flukso/kube/enclosure/kube.stl

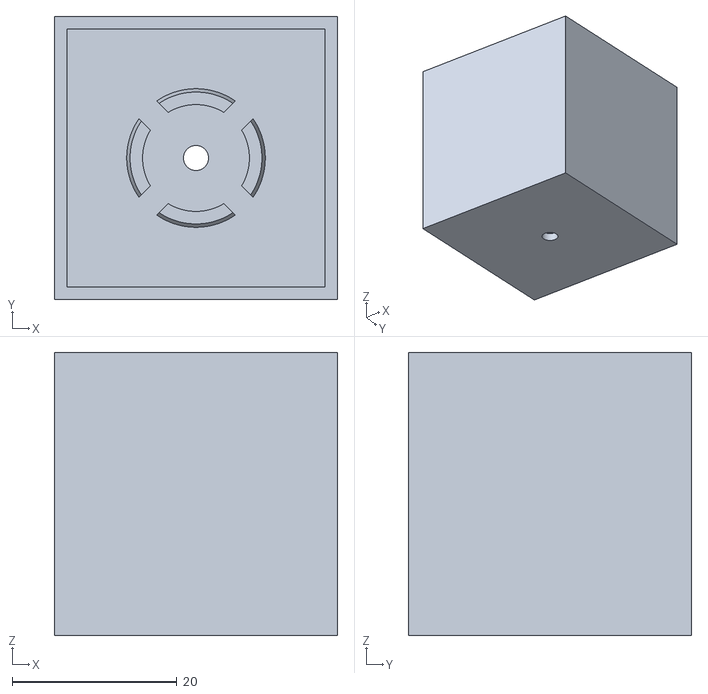
[picture p1: CAD file, 2015-09-16]
enclosure/kube.stl
34.4 x 34.4 x 34.4
