flukso/kube/FLK01B/FLK01B.brd

## EAGLE design FLK01B/FLK01B.brd (2015-07-14)

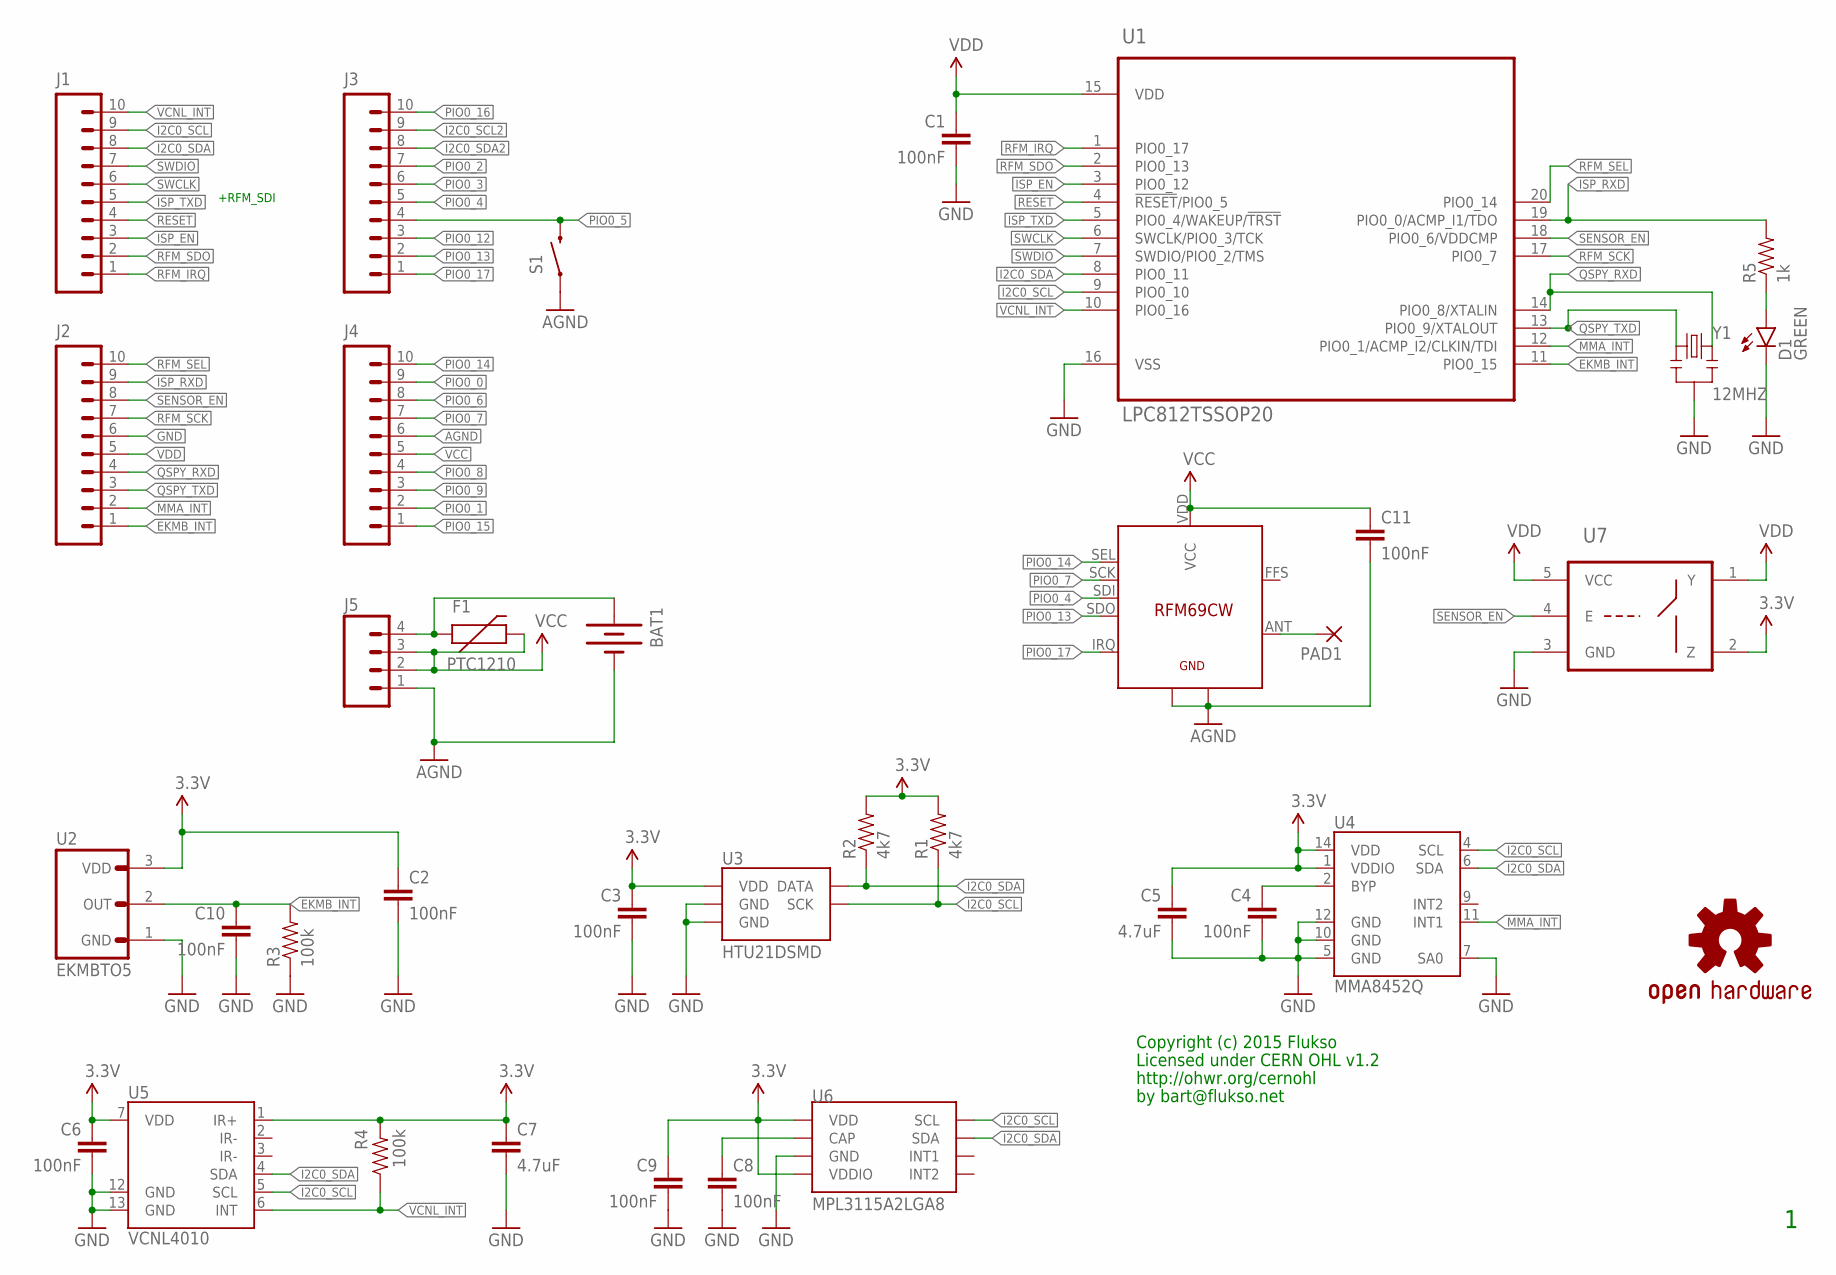
[picture p2: schematic FLK01B.sch]

Parts:
BAT1: BATTERY245PTH; BATTCON_245MM_PTH
C1, C2, C3, C4, C6, C8, C9, C10, C11: 100nF; 0402-CAP
C5, C7: 4.7uF; C0805K
D1: GREEN; LED-0603
F1: PTC1210; 1210
J1, J2: M10SMD_MALE_SHORT; 1X10_SMD_MALE_SHORT
J3, J4: M10SMD_FEMALE_SHORT; 1X10_SMD_FEMALE_SHORT
J5: M041X04_NO_SILK; 1X04_NO_SILK
PAD1: WIREPAD_1,6/0,8
R1, R2: 4k7; 0402-RES
R3, R4: 100k; 0402-RES
R5: 1k; 0402-RES
S1: SWITCH-MOMENTARY-2SMD; TACTILE_SWITCH_SMD
U1: LPC812TSSOP20; TSSOP20
U2: EKMBTO5; TO5
U3: HTU21DSMD; HTU21D
U4: MMA8452Q; QFN-16_0.5MM
U5: VCNL4010
U6: MPL3115A2LGA8; LGA8
U7: 741G66; SOT353
U$3: RFM69CW
U$7: OSHW-LOGOS; OSHW-LOGO-S
Y1: 12MHZ; RESONATOR-SMD

Connections:
3.3V: C2.1, C3.1, C5.1, C6.1, C7.1, C9.1, R1.2, R2.2, R4.2, U2.3 (VDD), U3.VDD, U4.1 (VDDIO), U4.14 (VDD), U5.1 (IR+), U5.7 (VDD), U6.1 (VDD), U6.4 (VDDIO), U7.2 (Z)
!ISP_EN!: J1.3, U1.3 (PIO0_12)
!RESET!: J1.4, U1.4 (!RESET!/PIO0_5)
AGND: BAT1.2 (-), C11.2, J4.6, J5.1, S1.1, U$3.GND1, U$3.GND2
EKMB_INT: C10.1, J2.1, R3.2, U1.11 (PIO0_15), U2.2 (OUT)
GND: C1.2, C2.2, C3.2, C4.2, C5.2, C6.2, C7.2, C8.2, C9.2, C10.2, D1.C, J2.6, R3.1, U1.16 (VSS), U2.1 (GND), U3.7 (GND), U3.GND, U4.5 (GND), U4.7 (SA0), U4.10 (GND), U4.12 (GND), U5.12 (GND), U5.13 (GND), U6.3 (GND), U7.3 (GND), Y1.2
I2C0_SCL: J1.9, R1.1, U1.9 (PIO0_10), U3.SCK, U4.4 (SCL), U5.5 (SCL), U6.8 (SCL)
I2C0_SCL2: J3.9
I2C0_SDA: J1.8, R2.1, U1.8 (PIO0_11), U3.DATA, U4.6 (SDA), U5.4 (SDA), U6.7 (SDA)
I2C0_SDA2: J3.8
ISP_RXD: J2.9, R5.2, U1.19 (PIO0_0/ACMP_I1/TDO)
ISP_TXD: J1.5, U1.5 (PIO0_4/WAKEUP/!TRST!)
MMA_INT: J2.2, U1.12 (PIO0_1/ACMP_I2/CLKIN/TDI), U4.11 (INT1)
unnamed: PAD1.1, U$3.ANT
unnamed: BAT1.3 (+), F1.1, J5.4
unnamed: C4.1, U4.2 (BYP)
unnamed: C8.1, U6.2 (CAP)
unnamed: D1.A, R5.1
PIO0_0: J4.9
PIO0_1: J4.2
PIO0_2: J3.7
PIO0_3: J3.6
PIO0_4: J3.5, U$3.SDI
PIO0_5: J3.4, S1.3 (2)
PIO0_6: J4.8
PIO0_7: J4.7, U$3.SCK
PIO0_8: J4.4
PIO0_9: J4.3
PIO0_12: J3.3
PIO0_13: J3.2, U$3.SDO
PIO0_14: J4.10, U$3.SEL
PIO0_15: J4.1
PIO0_16: J3.10
PIO0_17: J3.1, U$3.IRQ
QSPY_RXD: J2.4, U1.14 (PIO0_8/XTALIN), Y1.3
QSPY_TXD: J2.3, U1.13 (PIO0_9/XTALOUT), Y1.1
RFM_IRQ: J1.1, U1.1 (PIO0_17)
RFM_SCK: J2.7, U1.17 (PIO0_7)
RFM_SDO: J1.2, U1.2 (PIO0_13)
RFM_SEL: J2.10, U1.20 (PIO0_14)
SENSOR_EN: J2.8, U1.18 (PIO0_6/VDDCMP), U7.4 (E)
SWCLK: J1.6, U1.6 (SWCLK/PIO0_3/TCK)
SWDIO: J1.7, U1.7 (SWDIO/PIO0_2/TMS)
VCC: C11.1, F1.2, J4.5, J5.2, J5.3, U$3.VDD (VCC)
VCNL_INT: J1.10, R4.1, U1.10 (PIO0_16), U5.6 (INT)
VDD: C1.1, J2.5, U1.15 (VDD), U7.1 (Y), U7.5 (VCC)

Notes on the sheet:
Copyright (c) 2015 Flukso
Licensed under CERN OHL v1.2
http://ohwr.org/cernohl
by bart@flukso.net
+RFM_SDI

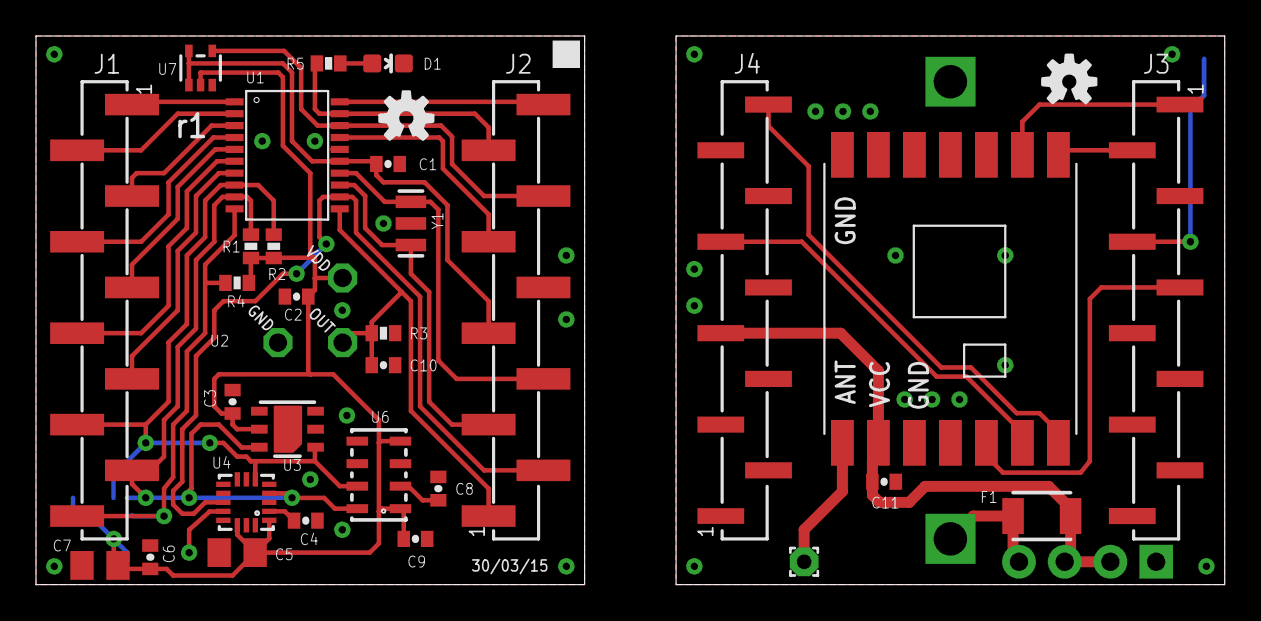
[picture p3: board FLK01B.brd from above]

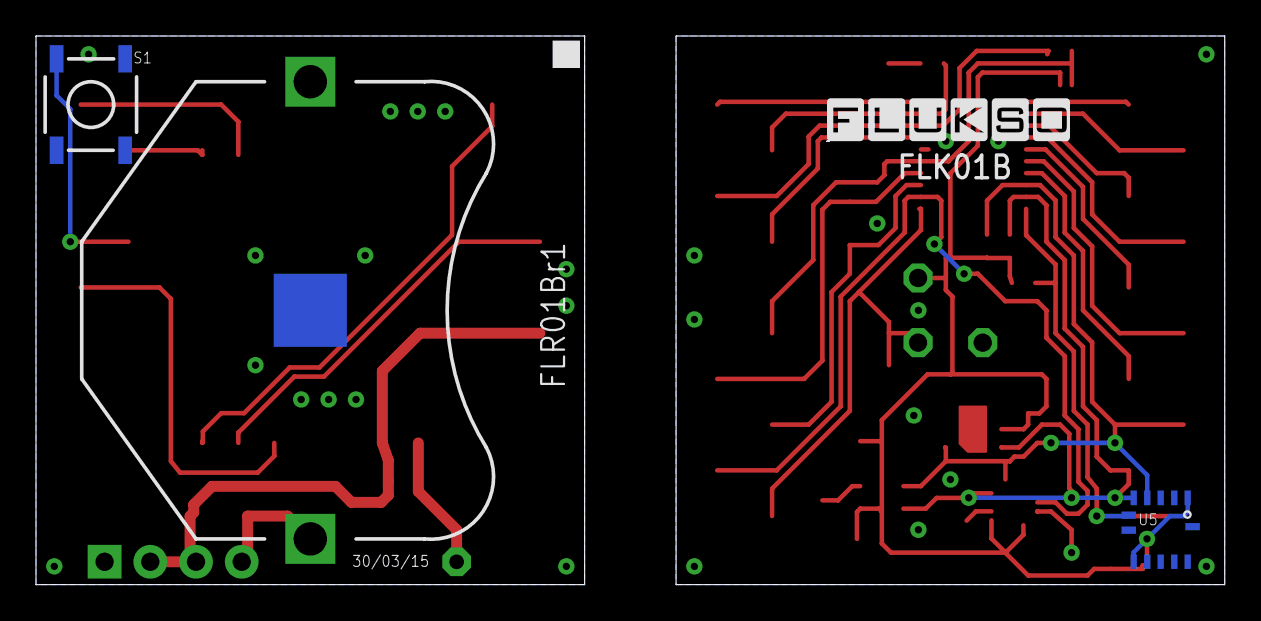
[picture p4: board FLK01B.brd from below]

Board: 2 copper layers, 66.0 x 30.5 mm, 38 parts (4 on the bottom side), 34 nets.

Other parts of the board:
U$1: OSHW-LOGOS; OSHW-LOGO-S
U$2: FLUKSO_LOGO_MEDIUM
