flukso/kube/FLT04A/FLT04A.brd

## EAGLE design FLT04A/FLT04A.brd (2015-03-15)

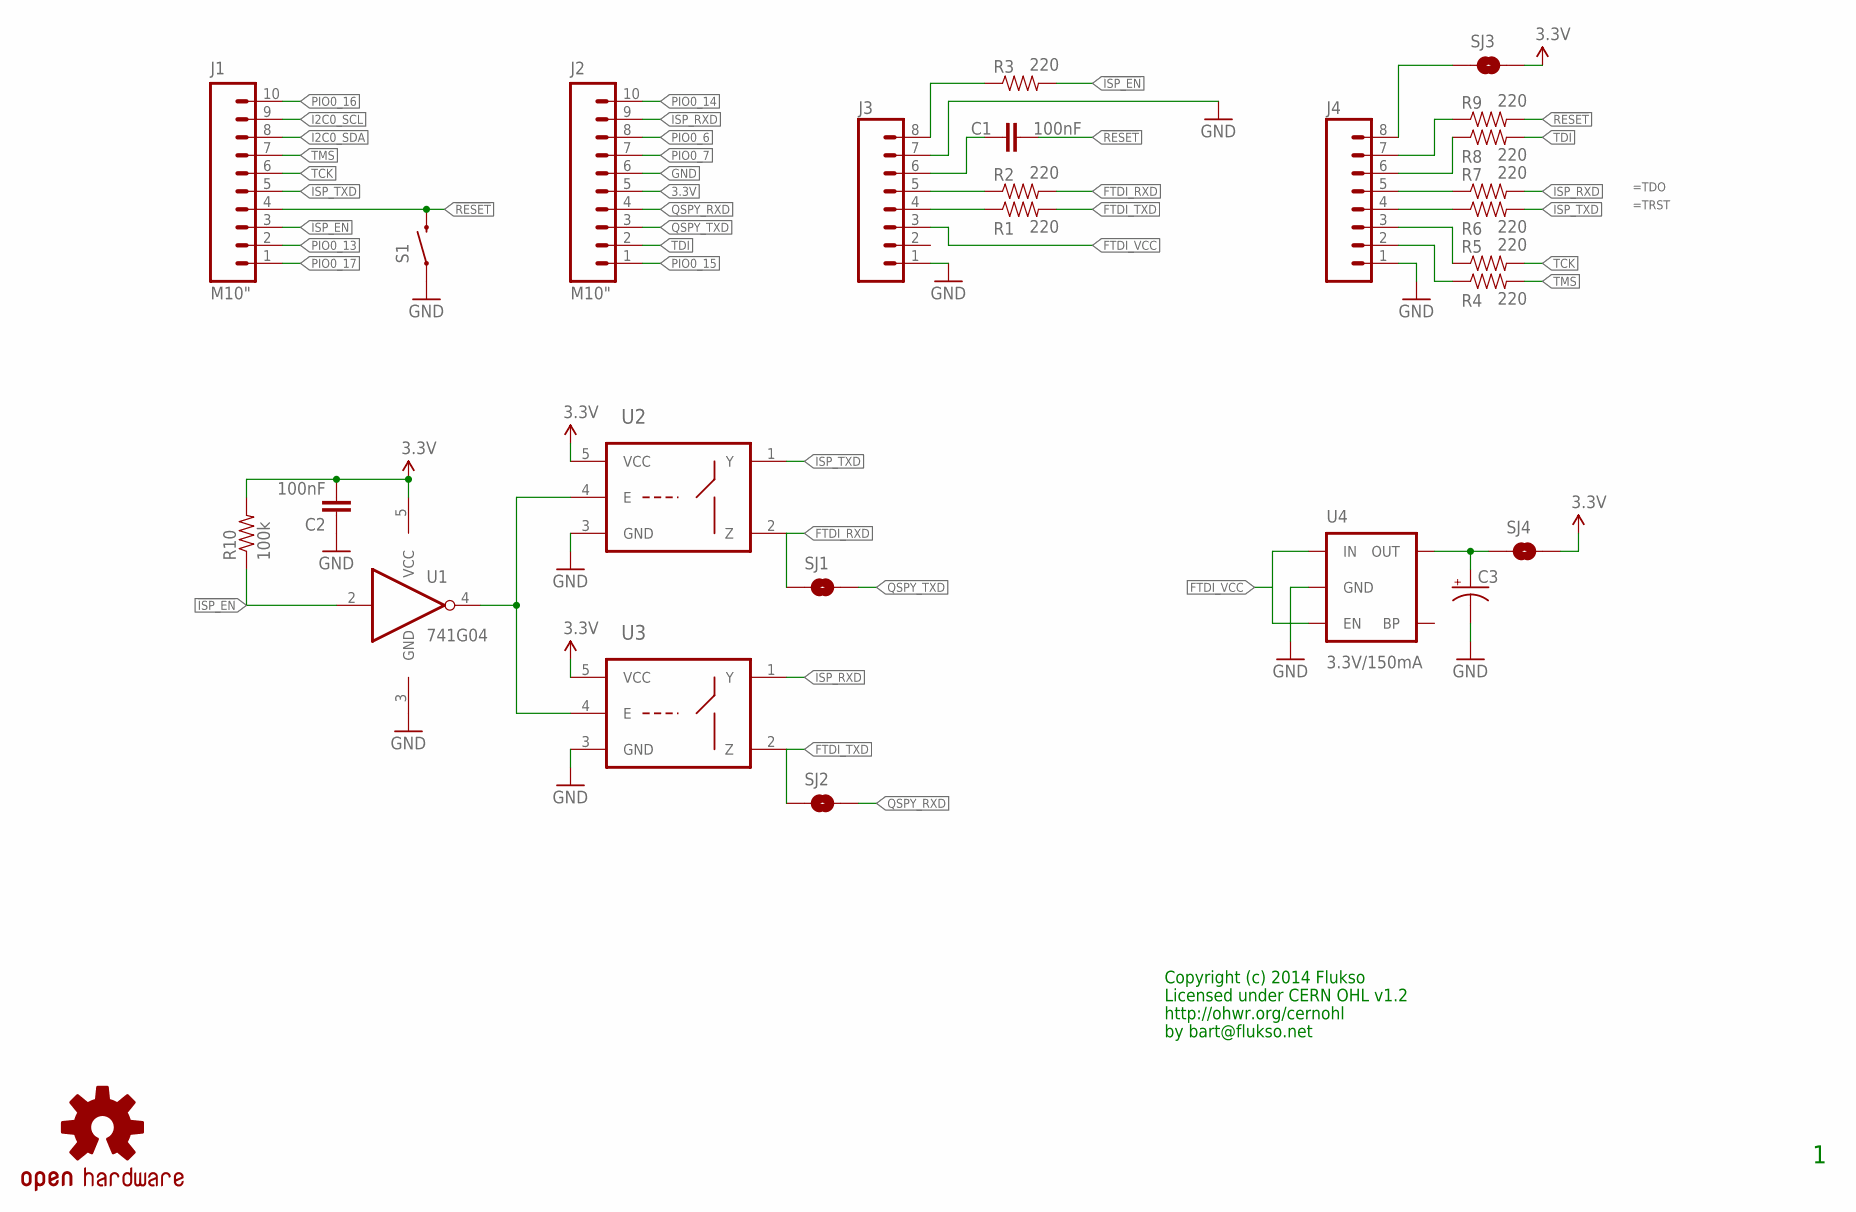
[picture p5: schematic FLT04A.sch]

Parts:
C1, C2: 100nF; 0402-CAP
C3: CAP_POL1206; EIA3216
J1, J2: M10"; 1X10
J3, J4: M08; 1X08_PIN1_NO_SILK
R1, R2, R3, R4, R5, R6, R7, R8, R9: 220; 0402-RES
R10: 100k; 0402-RES
S1: SWITCH-MOMENTARY-2SMD; TACTILE_SWITCH_SMD
SJ1, SJ2, SJ3, SJ4: SOLDERJUMPERNC; SJ_2S
U1: 741G04; SOT353
U2, U3: 741G66; SOT353
U4: 3.3V/150mA; SOT23-5
U$1: OSHW-LOGOS; OSHW-LOGO-S

Connections:
3.3V: C2.2, J2.5, R10.2, SJ3.2, SJ4.2, U1.5 (VCC), U2.5 (VCC), U3.5 (VCC)
!ISP_EN!: J1.3, R3.2, R10.1, U1.2 (I)
!RESET!: C1.2, J1.4, R9.2, S1.3 (2)
FTDI_RXD: R2.2, SJ1.1, U2.2 (Z)
FTDI_TXD: R1.2, SJ2.1, U3.2 (Z)
FTDI_VCC: J3.3, U4.1 (IN), U4.3 (EN)
GND: C2.1, C3.C (-), J2.6, J3.1, J3.7, J4.1, S1.1, U1.3 (GND), U2.3 (GND), U3.3 (GND), U4.2 (GND)
I2C0_SCL: J1.9
I2C0_SDA: J1.8
ISP_RXD: J2.9, R7.2, U3.1 (Y)
ISP_TXD: J1.5, R6.2, U2.1 (Y)
unnamed: J3.8, R3.1
unnamed: C1.1, J3.6
unnamed: J3.5, R2.1
unnamed: J3.4, R1.1
unnamed: U1.4 (O), U2.4 (E), U3.4 (E)
unnamed: J4.2, R4.1
unnamed: J4.3, R5.1
unnamed: J4.4, R6.1
unnamed: J4.5, R7.1
unnamed: J4.6, R8.1
unnamed: J4.8, SJ3.1
unnamed: J4.7, R9.1
unnamed: C3.A (+), SJ4.1, U4.5 (OUT)
PIO0_6: J2.8
PIO0_7: J2.7
PIO0_13: J1.2
PIO0_14: J2.10
PIO0_15: J2.1
PIO0_16: J1.10
PIO0_17: J1.1
QSPY_RXD: J2.4, SJ2.2
QSPY_TXD: J2.3, SJ1.2
TCK: J1.6, R5.2
TDI: J2.2, R8.2
TMS: J1.7, R4.2

Notes on the sheet:
Copyright (c) 2014 Flukso
Licensed under CERN OHL v1.2
http://ohwr.org/cernohl
by bart@flukso.net
=TDO
=TRST

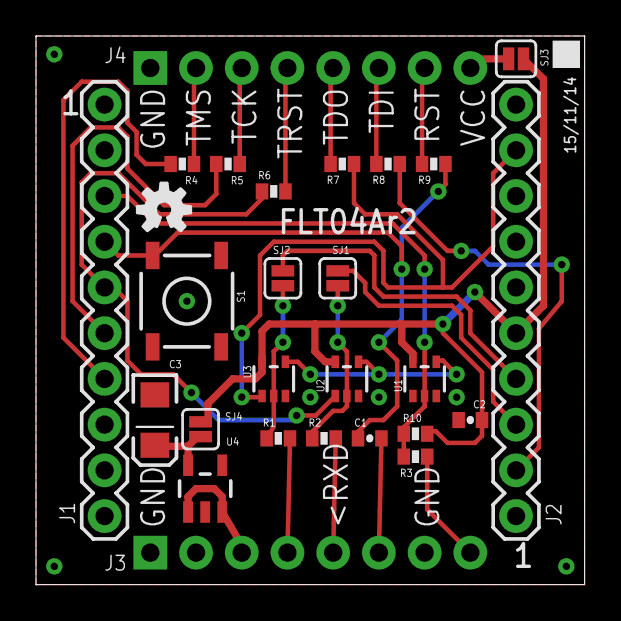
[picture p6: board FLT04A.brd from above]

Board: 2 copper layers, 30.5 x 30.5 mm, 27 parts (0 on the bottom side), 27 nets.
