flukso/kube/FLR01A/FLR01A.brd

## EAGLE design FLR01A/FLR01A.brd (2015-03-14)

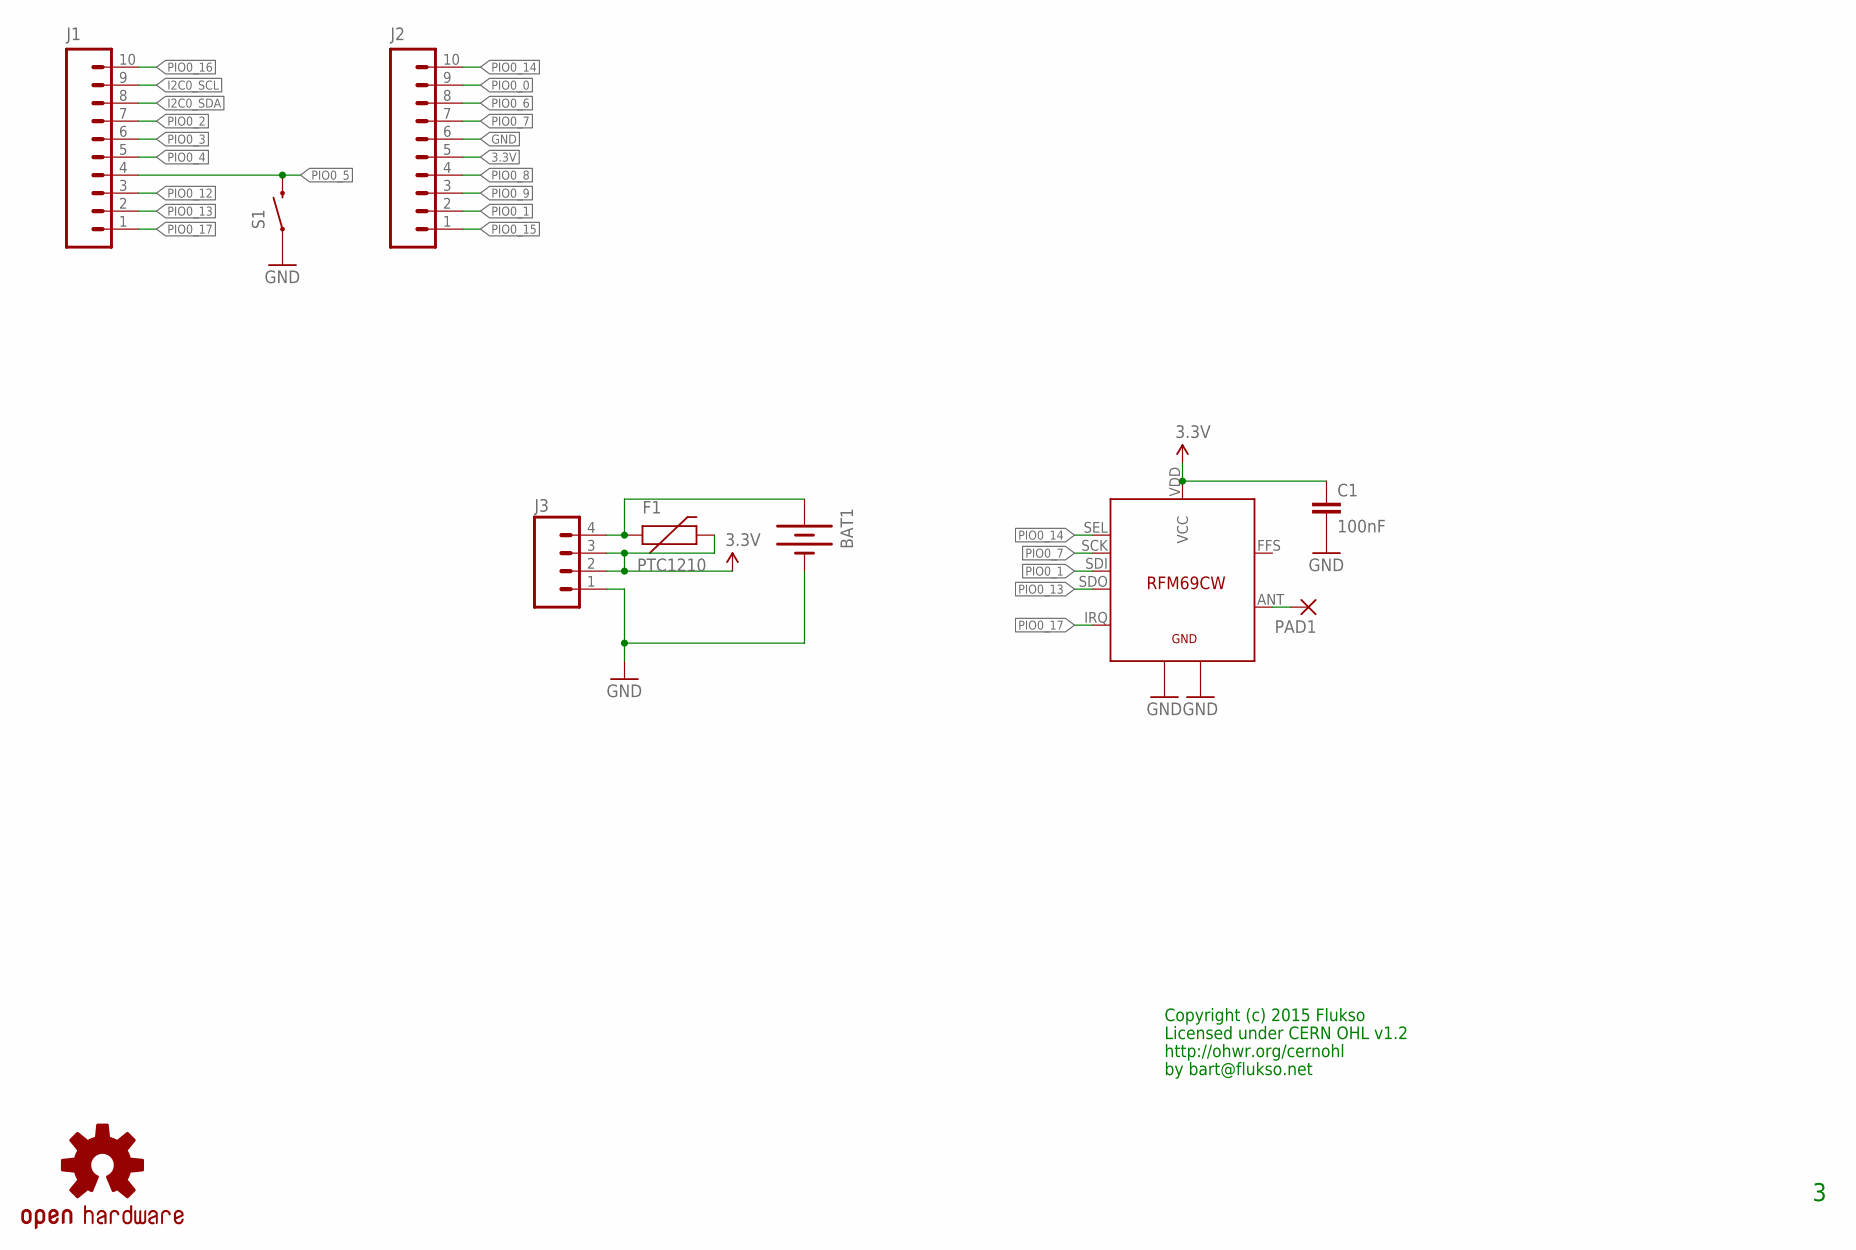
[picture p7: schematic FLR01A.sch]

Parts:
BAT1: BATTERY245PTH; BATTCON_245MM_PTH
C1: 100nF; 0402-CAP
F1: PTC1210; 1210
J1, J2: M10SMD_FEMALE_SHORT; 1X10_SMD_FEMALE_SHORT
J3: M041X04_NO_SILK; 1X04_NO_SILK
PAD1: WIREPAD_1,6/0,8
S1: SWITCH-MOMENTARY-2SMD; TACTILE_SWITCH_SMD
U$1: OSHW-LOGOS; OSHW-LOGO-S
U$2: RFM69CW

Connections:
3.3V: C1.1, F1.2, J2.5, J3.2, J3.3, U$2.VDD (VCC)
GND: BAT1.2 (-), C1.2, J2.6, J3.1, S1.1, U$2.GND1, U$2.GND2
I2C0_SCL: J1.9
I2C0_SDA: J1.8
unnamed: BAT1.3 (+), F1.1, J3.4
unnamed: PAD1.1, U$2.ANT
PIO0_0: J2.9
PIO0_1: J2.2, U$2.SDI
PIO0_2: J1.7
PIO0_3: J1.6
PIO0_4: J1.5
PIO0_5: J1.4, S1.3 (2)
PIO0_6: J2.8
PIO0_7: J2.7, U$2.SCK
PIO0_8: J2.4
PIO0_9: J2.3
PIO0_12: J1.3
PIO0_13: J1.2, U$2.SDO
PIO0_14: J2.10, U$2.SEL
PIO0_15: J2.1
PIO0_16: J1.10
PIO0_17: J1.1, U$2.IRQ

Notes on the sheet:
Copyright (c) 2015 Flukso
Licensed under CERN OHL v1.2
http://ohwr.org/cernohl
by bart@flukso.net

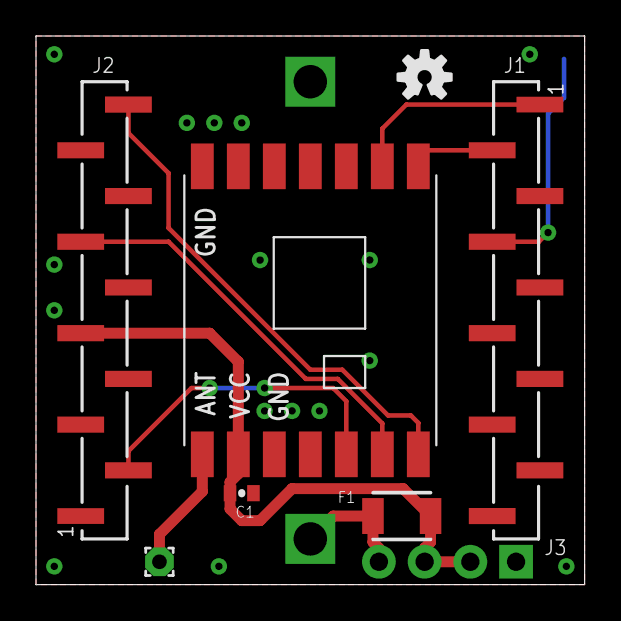
[picture p8: board FLR01A.brd from above]

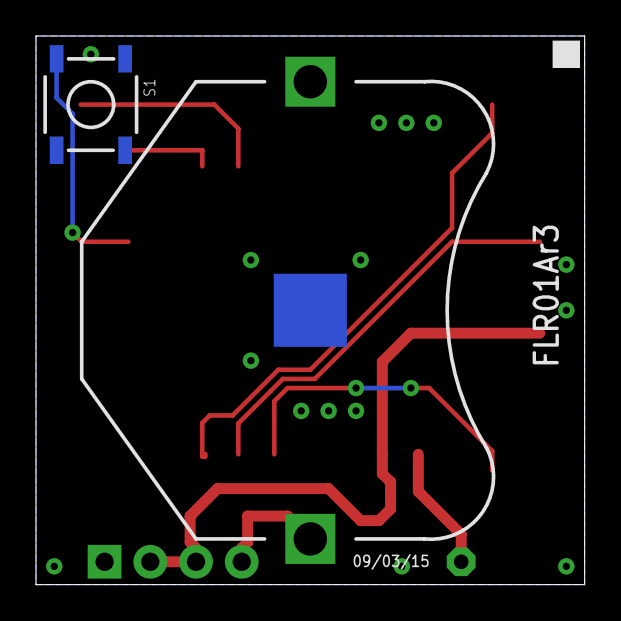
[picture p9: board FLR01A.brd from below]

Board: 2 copper layers, 30.5 x 30.5 mm, 10 parts (2 on the bottom side), 10 nets.
