flukso/kube/src/flk01/vcnl4k.h

#ifndef __VCNL4K_H__
#define __VCNL4K_H__

#include "i2c.h"

#define VCNL4K_ID "vcnl4k"
#define VCNL4K_ADDRESS 0x13
#define VCNL4K_REG_COMMAND 0x80
#define VCNL4K_REG_PID 0x81
#define VCNL4K_REG_IR_LED_CURRENT 0x83
#define VCNL4K_REG_LIGHT_PAR 0x84
#define VCNL4K_REG_LIGHT_RESULT 0x85
#define VCNL4K_REG_PROX_RESULT 0x87
#define VCNL4K_REG_PROX_FREQ 0x89
#define VCNL4K_REG_PROX_TIMING 0x8A

#define VCNL4K_CMD_START_ALS 0x10

#define VCNL4K_SAMPLE_ERR 0xFFFF

void vcnl4k_init(void);
ErrorCode_t vcnl4k_read_pid(void);
uint8_t vcnl4k_sample_light(uint16_t *sample);

#endif
