flukso/kube/(commit log)

2014-01-07 [eagle] first exercise
    [FLQ01A.brd, FLQ01A.sch, FLR01A.brd, FLR01A.sch, FLT04A.brd, FLT04A.sch]
2014-01-22 [scad] first enclosure iteration in openscad
    [kube.scad]
2014-01-22 [scad] parameterize kube dimensions
    [kube.scad]
2014-01-22 [scad] add kube scaling factor
    [kube.scad]
2014-01-22 [scad] use support + ring for fixing the magnet
    [kube.scad]
2014-01-22 [scad] pretty print parameters
    [kube.scad]
2014-01-25 [scad] lower base thickness to wall_w
    [kube.scad]
2014-01-25 [scad] increase ring tolerance
    [kube.scad]
2014-01-25 [scad] reduce wall thickness to 1mm
    [kube.scad]
2014-01-26 [scad] go for a hollow support
    [kube.scad]
2014-01-26 [scad] add a small hole for pushing out the pcb
    [kube.scad]
2014-10-25 [debug] add i2c init and basic htu21d comms
2014-10-28 [debug] sleep now triggers a power down
2014-10-30 [i2c] swap SDA and SCL pins again
2014-10-31 [i2c] group i2c handler vars into a struct
2014-11-01 [led] disable internal pull-up on led pin
2014-11-02 [dbg] add a DEBUG compilation switch
2014-11-02 [clkout] disable pull-up on pin 3
2014-11-09 [ekmb] clear interrupt status at init
2014-11-09 [boot] correctly configure pull-ups to minimize power consumption
    [main.c]
2014-11-10 [boot] trigger a reset every 2^16 secs
    [main.c]
2014-11-11 [rfm] enable standby/powerdown modes in sendWait
2014-11-11 [rfm] limit tx power to 10dBm
2014-11-11 [pwr] put M0+ in low current mode
2014-11-11 [boot] configure led pin
2014-11-11 [i2c] increase timeout tenfold
2014-11-11 [i2c] reset i2c block at init
    [main.c]
2014-11-11 [htu21d] sample every 64sec
2014-11-15 [pcb] kick off rev2
    [FLQ01A.brd, FLQ01A.sch]
2014-11-15 [pcb] rename FLQ01A to FLK01A
    [FLK01A.brd, FLK01A.sch]
2014-11-15 [pcb] clarify pin functions
    [FLK01A.brd, FLK01A.sch]
2014-11-15 [pcb] re-assign sensor interrupt pins
    [FLK01A.brd, FLK01A.sch]
2014-11-15 [pcb] increase C5 size from 0603 to 0805
    [FLK01A.brd, FLK01A.sch]
2014-11-15 [pcb] correct HTU21D footprint
    [FLK01A.brd, FLK01A.sch]
2014-11-15 [pcb] rename passives
    [FLK01A.brd, FLK01A.sch]
2014-11-16 [pcb] update board layout
    [FLK01A.brd, FLK01A.sch]
2014-11-16 [pcb] use smaller + round pads for I2C header
    [FLK01A.brd, FLK01A.sch]
2014-11-16 [flt] add pull-up to ISP_EN pin
    [FLT04A.brd, FLT04A.sch]
2014-11-16 [flr] update RFM69 silkscreen
    [FLR01A.brd, FLR01A.sch]
2014-11-16 [flr] add ptc fuse in series with battery
    [FLR01A.brd, FLR01A.sch]
2014-11-16 [flr] improve pcb routing
    [FLR01A.brd]
2014-11-22 [i2c] clear the bus on error
    [main.c]
2014-11-23 [boot] put RFM_SDO pin in repeater mode
2014-12-14 [i2c] switch to interrupt-driven communication
2014-12-14 [rfm] switch to a 868.3MHz center frequency
2014-12-15 [rfm] add spi pinassigns to app sw
2014-12-16 [rfm] insert 16clk delays in spi communication
2015-01-07 [spi] slow down the spi clk to 1MHz
2015-02-15 [mpl3115] add support for pressure readings
2015-02-16 [i2c] compact debugging string
2015-02-16 [i2c] define sensor ids in their respective header files
2015-03-05 [sample] return to 64sec interval
2015-03-07 [wwdt] log watchdog event as bit 8 in error byte
    [main.c, pkt.h]
2015-03-09 [flk/flr] introduce r3 of sensor and radio board
    [FLK01A.brd, FLK01A.sch, FLR01A.brd, FLR01A.sch]
2015-03-14 [flk/flr] adapt board layout to new M10 footprints + power switch
    [FLK01A.brd, FLK01A.sch, FLR01A.brd, FLR01A.sch]
2015-03-15 [flk] connect VCNL4010 int pin to LPC812
    [FLK01A.brd, FLK01A.sch]
2015-03-15 [flt] 10uF cap did not connect to GND
    [FLT04A.brd, FLT04A.sch]
2015-04-01 [flk/r] fusion of sensor and radio board
    [FLK01B.brd, FLK01B.sch]
2015-07-14 [flk/r] minor changes to layout
    [FLK01B.brd, FLK01B.sch]
2015-07-15 [flk01b] move SPI0_MOSI function from pin 1 to 4
2015-07-15 [flk01b] move MMA_INT from pin 16 to 1
2015-07-15 [flk01b] VCNL_INT connects to pin 16
2015-07-26 [mma8452] init accelerometer and send dedicated packet
2015-07-26 [i2c] init I2C_PARAM_T differently to remove memset dependency with -Os
2015-07-26 [mpl+vcnl] add light and pressure readings to gauge packet
2015-07-27 [mma8452] add mma i2c check to error bitfield
    [main.c, mma8452.c, mma8452.h, pkt.h]
2015-07-27 [mma8452] set the accelerometer to low-power mode
2015-09-16 [scad] add ring magnet snap-to-fit
    [kube.stl]
2015-09-26 [debug] add openocd stlink v2 cfg script
    [stlinkv2_lpc812.cfg]
